Qv1k-bits/smartknob/electronics/view_base/view_base.kicad_pcb

## KiCad design electronics/view_base/view_base.kicad_pcb (2024-01-25)

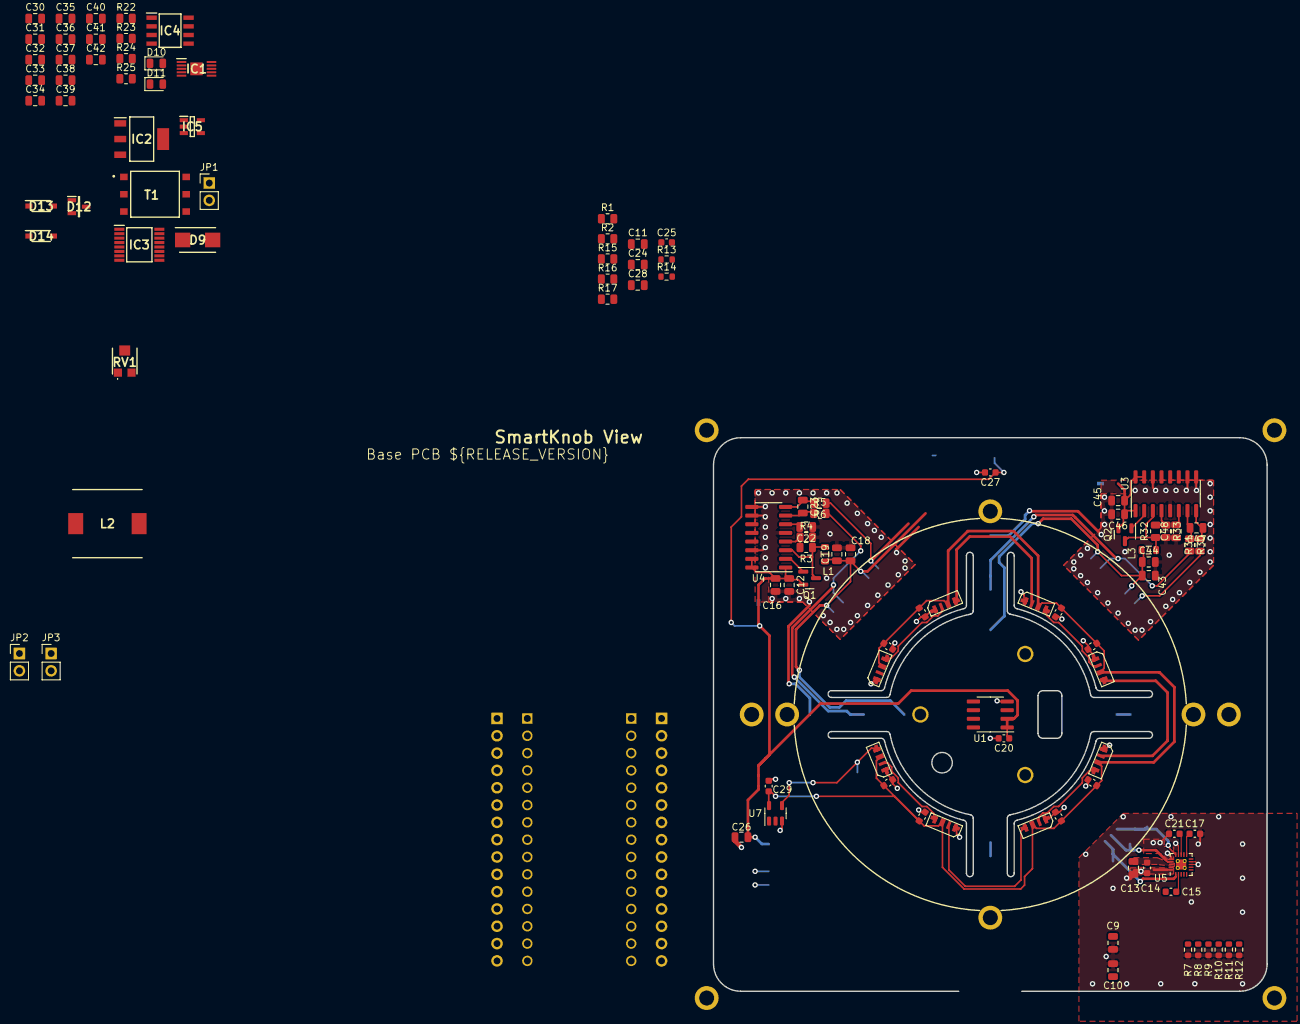
[picture p1: board view_base.kicad_pcb from above]

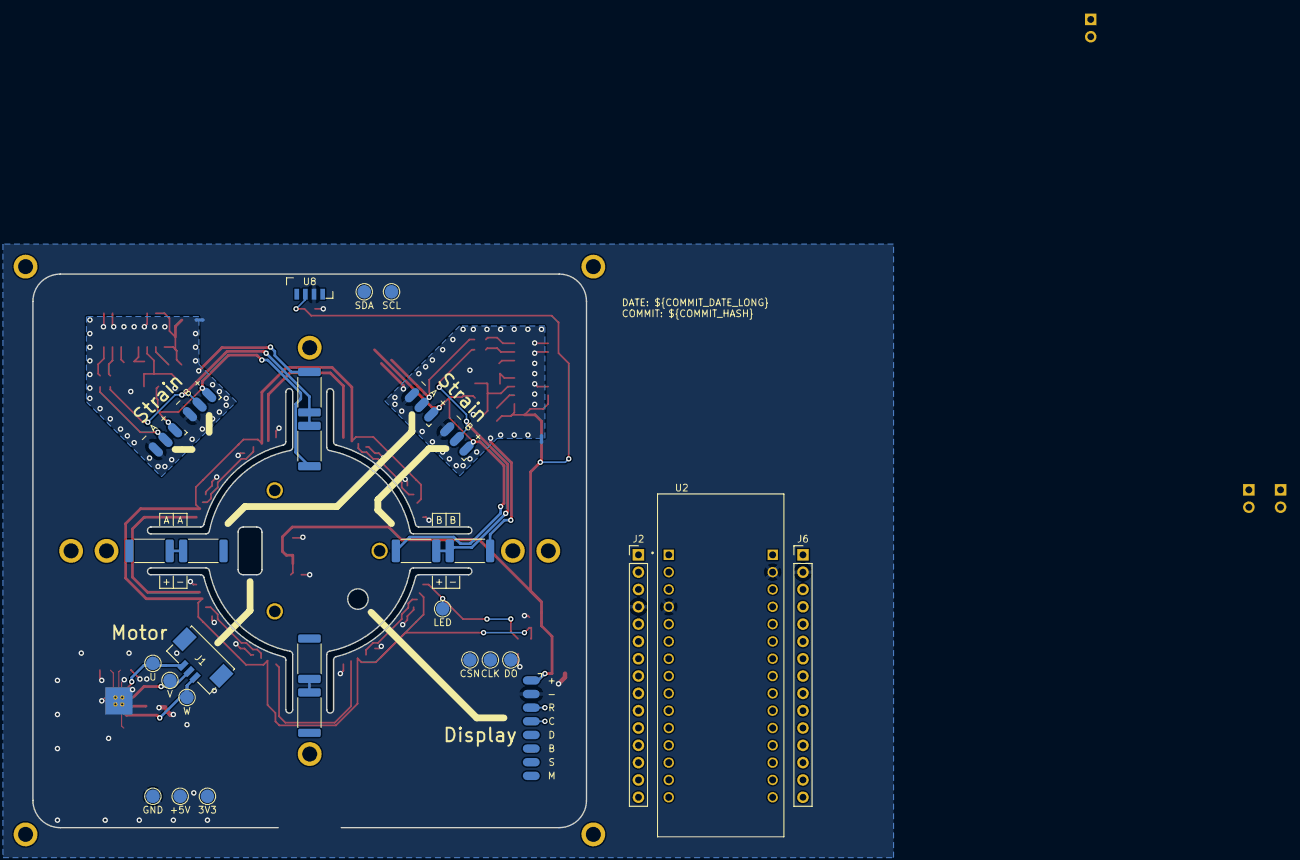
[picture p2: board view_base.kicad_pcb from below]

Board: 2 copper layers, 81.2 x 81.2 mm, 158 parts (32 on the bottom side), 91 nets.

Parts:
C1, C2, C3, C4, C5, C6, C7, C8, C14, C15, C17, C20, C21, C25, C27, C29: 0.1uF; C_0603_1608Metric
C9: 10uF/50V; C_0805_2012Metric
C10, C30, C32, C38, C41: 100nF; C_0805_2012Metric
C11, C31: 10nF; C_0805_2012Metric
C12, C19, C22, C23, C44, C46, C47, C48: 0.1uF; C_0805_2012Metric
C13: 22uF; C_0805_2012Metric
C16, C18, C24, C26, C43, C45: 10uF; C_0805_2012Metric
C28, C33: 3nF; C_0805_2012Metric
C34: 8.2pF; C_0805_2012Metric
C35, C36, C37: 47uF; C_0805_2012Metric
C39: 4.7u; C_0805_2012Metric
C40, C42: 50/1uF; C_0805_2012Metric
D1, D2, D3, D4, D5, D6, D7, D8: SK6812SIDE-A; SK6812-SIDE-A
D9: B360B-13-F; DIOM5336X250N
D10: Green; D_0805_2012Metric
D11: Red; D_0805_2012Metric
D12: SP712-02HTG; SOT95P237X115-3N
D13, D14: MBR0520L-TP; SOD3716X135N
H1, H2, H3: MotorHole; MountingHole_M1.6
H4, H5, H6, H7, H10, H11, H12, H13: MountHole; MountingHole_2.2mm_M2_ISO7380_Pad_NonVirtual
H8, H9: AlignmentHole; MountingHole_2.2mm_M2_ISO7380_Pad_NonVirtual
IC1: TPS54240DGQR; SOP50P490X110-11N
IC2: MCP1826ST-3302E_DB; SOT230P700X180-4N
IC3: TCA9534APWR; SOP65P640X120-16N
IC4: ISO1044BDR; SOIC127P600X175-8N
IC5: SN6501QDBVRQ1; SOT95P280X145-5N
J1: BLDC; 532610371
J2, J6: Conn_01x15; PinHeader_1x15_P2.54mm_Vertical
J3: LCD; SolderPads_2mm_8
J4, J7: A; SolderPads_2mm_3_STRAIN
J5, J8: B; SolderPads_2mm_3_STRAIN
JP1: PinHeader_1x02_P2.54mm_Vertical
JP2, JP3: Jumper_2_Open; PinHeader_1x02_P2.54mm_Vertical
L1, L3: 3.3uH; L_0805_2012Metric
L2: 10uH; INDPM102100X400N
NT1, NT2: NetTie_2; NetTie-2_SMD_Pad0.5mm
Q1, Q2: MMBT4403; SOT-23
R1: 105k; R_0805_2012Metric
R2: 12k1; R_0805_2012Metric
R3, R16, R23, R32: 10k; R_0805_2012Metric
R4, R33: 8.2k; R_0805_2012Metric
R5, R6, R30, R31: 100; R_0805_2012Metric
R7, R8, R9, R10, R11, R12: 10k; R_0603_1608Metric
R13, R14: 2.2k; R_0603_1608Metric
R15: 249k; R_0805_2012Metric
R17: 36k5; R_0805_2012Metric
R18, R19, R20, R21, R26, R27, R28, R29: 330; R_2512_6332Metric
R22: ~50k; R_0805_2012Metric
R24: 1k; R_0805_2012Metric
R25: 120; R_0805_2012Metric
RV1: 5k; TC33X2503E
T1: 760390014; 760390015
TP1: 3V3; TestPoint_Pad_D2.0mm_ValueSilk
TP2: GND; TestPoint_Pad_D2.0mm_ValueSilk
TP3: +5V; TestPoint_Pad_D2.0mm_ValueSilk
TP4: SDA; TestPoint_Pad_D2.0mm_ValueSilk
TP5: SCL; TestPoint_Pad_D2.0mm_ValueSilk
TP6: U; TestPoint_Pad_D2.0mm_ValueSilk
TP7: V; TestPoint_Pad_D2.0mm_ValueSilk
TP8: W; TestPoint_Pad_D2.0mm_ValueSilk
TP9: CSN; TestPoint_Pad_D2.0mm_ValueSilk
TP10: CLK; TestPoint_Pad_D2.0mm_ValueSilk
TP11: DO; TestPoint_Pad_D2.0mm_ValueSilk
TP12: LED; TestPoint_Pad_D2.0mm_ValueSilk
U1: MT6701-CT; SOIC-8_3.9x4.9mm_P1.27mm
U2: NUCLEO-L432KC; MODULE_NUCLEO-L432KC
U3, U4: HX711; SOIC-16_3.9x9.9mm_P1.27mm
U5: TMC6300; QFN-20-1EP_3x3mm_P0.4mm_EP1.65x1.65mm_ThermalVias_LargerVia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
U7: SN74LV1T34DBV; SOT-23-5
U8: VEML7700; VEML7700-TOP
Z5: dummy_keepouts; ViewKeepouts3d
Z6, Z7, Z8: RotorScrew (BOM-only); bom_only_no_pin
Z9: WatchGlass39.5mm; bom_only_no_pin
Z10: BLDCMotor; bom_only_no_pin

Connections:
+3V3: C12.1, C16.1, C17.1, C20.1, C26.1, C27.1, C30.1, C31.1, C38.1, C39.1, C45.1, C46.1, IC2.3 (VOUT), IC3.16 (VCC), IC4.1 (VCC1), J3.1, J6.14, Q1.2 (E), Q2.2 (E), R13.1, R14.1, TP1.1, U1.1 (VDD), U1.2 (MODE), U2.CN4_14 (+3V3), U3.1 (VSUP), U3.15 (RATE), U3.16 (DVDD), U4.1 (VSUP), U4.15 (RATE), U4.16 (DVDD), U5.11 (VIO/~STDBY), U8.2 (VDD)
+5V: C1.1, C2.1, C3.1, C4.1, C5.1, C6.1, C7.1, C8.1, C10.1, C11.1, C13.1, C14.1, C15.1, C24.1, C25.1, C29.1, C35.1, C36.1, C37.1, C40.1, D1.2 (VDD), D2.2 (VDD), D3.2 (VDD), D4.2 (VDD), D5.2 (VDD), D6.2 (VDD), D7.2 (VDD), D8.2 (VDD), D11.1 (K), IC2.1 (VIN), IC5.2 (VCC), J6.4, JP3.1 (A), JP3.2 (B), L2.2, RV1.2, T1.2, TP3.1, U2.CN4_4 (+5V), U5.18 (VS), U7.5 (VCC)
+5VP: C41.1, C42.1, D13.1 (K), D14.1 (K), IC4.8 (VCC2)
+12V: C9.1, IC1.2 (VIN), JP2.2 (B), R1.1, R16.1
/AREF: J6.13, U2.CN4_13 (AREF)
/CANH: D12.2 (K_2), IC4.6 (CANH), JP1.1 (A)
/CANL: D12.1 (K_1), IC4.5 (CANL), R25.2
/LED_DATA_5V: D1.1 (DIN), TP12.1, U7.4 (Y)
/MAG_CSN: TP9.1, U1.8 (Z/W/CSN)
/NRST_CN3: J2.3, U2.CN3_3 (NRST_CN3)
/NRST_CN4: J6.3, U2.CN4_3 (NRST_CN4)
/PA0: J6.12, U2.CN4_12 (PA0)
/PA1: J6.11, U2.CN4_11 (PA1)
/PA2: J6.5, U2.CN4_5 (PA2)
/PA3: J6.10, U2.CN4_10 (PA3)
/PA4: J6.9, U2.CN4_9 (PA4)
/PA5: J6.8, U2.CN4_8 (PA5)
/PA6: J6.7, U2.CN4_7 (PA6)
/PA7: J6.6, U2.CN4_6 (PA7)
/PA8: J2.12, U2.CN3_12 (PA8)
/PA9: IC3.14 (SCL), J2.1, J3.4, R14.2, TP5.1, TP10.1, U1.7 (B/V/SCL/CLK), U2.CN3_1 (PA9), U8.1 (SCL)
/PA10: IC3.15 (SDA), J2.2, J3.5, R13.2, TP4.1, TP11.1, U1.6 (A/U/SDA/DO), U2.CN3_2 (PA10), U8.4 (SDA)
/PB0: J2.6, U2.CN3_6 (PB0)
/PB1: J2.9, U2.CN3_9 (PB1)
/PB3: J6.15, U2.CN4_15 (PB3)
/PB4: J2.15, U2.CN3_15 (PB4)
/PB5: J2.14, U2.CN3_14 (PB5)
/PB6: J2.8, U2.CN3_8 (PB6)
/PB7: J2.7, U2.CN3_7 (PB7)
/PC14: J2.10, U2.CN3_10 (PC14)
/PC15: J2.11, U2.CN3_11 (PC15)
/Strain_sensor_1/STRAIN_E+: C43.1, C44.1, J7.1, J8.1, L3.2, R26.1, R28.2
/Strain_sensor_1/STRAIN_S+: J7.2, R26.2, R27.1, R31.1
/Strain_sensor_1/STRAIN_S-: J8.2, R28.1, R29.2, R30.2
/Strain_sensor_2/STRAIN_E+: C18.1, C19.1, J4.1, J5.1, L1.2, R18.1, R20.2
/Strain_sensor_2/STRAIN_S+: J4.2, R6.1, R18.2, R19.1
/Strain_sensor_2/STRAIN_S-: J5.2, R5.2, R20.1, R21.2
/TMC_DIAG: IC3.4 (P0), U5.12 (DIAG)
/TMC_UH: IC3.5 (P1), R7.1, U5.3 (UH)
/TMC_UL: IC3.6 (P2), R10.1, U5.6 (UL)
/TMC_VH: IC3.7 (P3), R8.1, U5.4 (VH)
/TMC_VL: IC3.9 (P4), R12.1, U5.10 (VL)
/TMC_WH: IC3.10 (P5), R9.1, U5.5 (WH)
/TMC_WL: IC3.11 (P6), R11.1, U5.7 (WL)
/VIN: J6.1, JP2.1 (A), U2.CN4_1 (VIN)
/stm32.CAN_RD: IC4.3 (RXD), J2.13, U2.CN3_13 (PA11)
/stm32.CAN_TD: IC4.2 (TXD), J2.5, U2.CN3_5 (PA12)
GND: C1.2, C2.2, C3.2, C4.2, C5.2, C6.2, C7.2, C8.2, C9.2, C10.2, C11.2, C13.2, C14.2, C17.2, C20.2, C21.2, C24.2, C25.2, C26.2, C27.2, C28.2, C29.2, C30.2, C31.2, C33.2, C34.2, C35.2, C36.2, C37.2, C38.2, C39.2, C40.2, D1.4 (VSS), D2.4 (VSS), D3.4 (VSS), D4.4 (VSS), D5.4 (VSS), D6.4 (VSS), D7.4 (VSS), D8.4 (VSS), D9.2 (A), IC1.9 (GND), IC1.11 (EP), IC2.2 (GND_1), IC2.4 (GND_2), IC3.1 (A0), IC3.2 (A1), IC3.3 (A2), IC3.8 (GND), IC4.4 (GND1), IC5.4 (GND_1), IC5.5 (GND_2), J2.4, J3.2, J6.2, NT1.2, NT2.2, R2.2, R7.2, R8.2, R9.2, R10.2, R11.2, R12.2, R15.2, R23.2, R24.2, TP2.1, U1.4 (GND), U2.CN3_4 (GND_CN3), U2.CN4_2 (GND_CN4), U5.8 (GND), U5.9 (GND), U5.14 (GND), U5.16 (BRUV), U5.20 (BRW), U5.PAD, U7.3 (GND), U8.3 (GND)
GNDA: C12.2, C16.2, C18.2, C19.2, C22.1, C43.2, C44.2, C45.2, C46.2, C48.1, J4.3, J5.3, J7.3, J8.3, NT1.1, NT2.1, R4.2, R19.2, R21.1, R27.2, R29.1, R33.2, U3.5 (AGND), U3.9 (INB-), U3.10 (INB+), U3.14 (XI), U4.5 (AGND), U4.9 (INB-), U4.10 (INB+), U4.14 (XI)
GNDS: C41.2, C42.2, D12.3 (COMMON), IC4.7 (GND2), T1.5
unnamed: C33.1, R17.1
unnamed: D1.3 (DOUT), D2.1 (DIN)
unnamed: D2.3 (DOUT), D3.1 (DIN)
unnamed: D3.3 (DOUT), D4.1 (DIN)
unnamed: D4.3 (DOUT), D5.1 (DIN)
unnamed: D5.3 (DOUT), D6.1 (DIN)
unnamed: D6.3 (DOUT), D7.1 (DIN)
unnamed: D7.3 (DOUT), D8.1 (DIN)
unnamed: C32.1, D9.1 (K), IC1.10 (PH), L2.1
unnamed: D10.2 (A), R16.2
unnamed: D10.1 (K), IC1.6 (PWRGD)
unnamed: D11.2 (A), R24.1
unnamed: D13.2 (A), T1.6
unnamed: D14.2 (A), T1.4
unnamed: C32.2, IC1.1 (BOOT)
unnamed: C34.1, IC1.8 (COMP), R17.2
unnamed: IC1.3 (EN), R1.2, R2.1
unnamed: IC1.5 (RT/CLK), R15.1
unnamed: C28.1, IC1.4 (SS/TR)
unnamed: IC1.7 (VSENSE), R22.2, R23.1
unnamed: IC5.1 (D1), T1.3
unnamed: IC5.3 (D2), T1.1
unnamed: J1.1, TP8.1, U5.1 (W)
unnamed: J1.2, TP7.1, U5.17 (V)
unnamed: J1.3, TP6.1, U5.15 (U)
unnamed: JP1.2 (B), R25.1
unnamed: Q1.1 (B), U4.2 (BASE)
unnamed: L1.1, Q1.3 (C), R3.1, U4.3 (AVDD)
unnamed: Q2.1 (B), U3.2 (BASE)
unnamed: L3.1, Q2.3 (C), R32.1, U3.3 (AVDD)
unnamed: R22.1, RV1.1
unnamed: C47.1, R31.2, U3.8 (INA+)
unnamed: C47.2, R30.1, U3.7 (INA-)
unnamed: C48.2, U3.6 (VBG)
unnamed: R32.2, R33.1, U3.4 (VFB)
unnamed: C23.1, R6.2, U4.8 (INA+)
unnamed: C23.2, R5.1, U4.7 (INA-)
unnamed: C22.2, U4.6 (VBG)
unnamed: R3.2, R4.1, U4.4 (VFB)
unnamed: C21.1, U5.13 (1V8OUT)
unnamed: C15.2, U5.2 (VCP)
